FTIndustries/FTUno/ftuno.kicad_pcb

## KiCad design ftuno.kicad_pcb (2024-12-11)

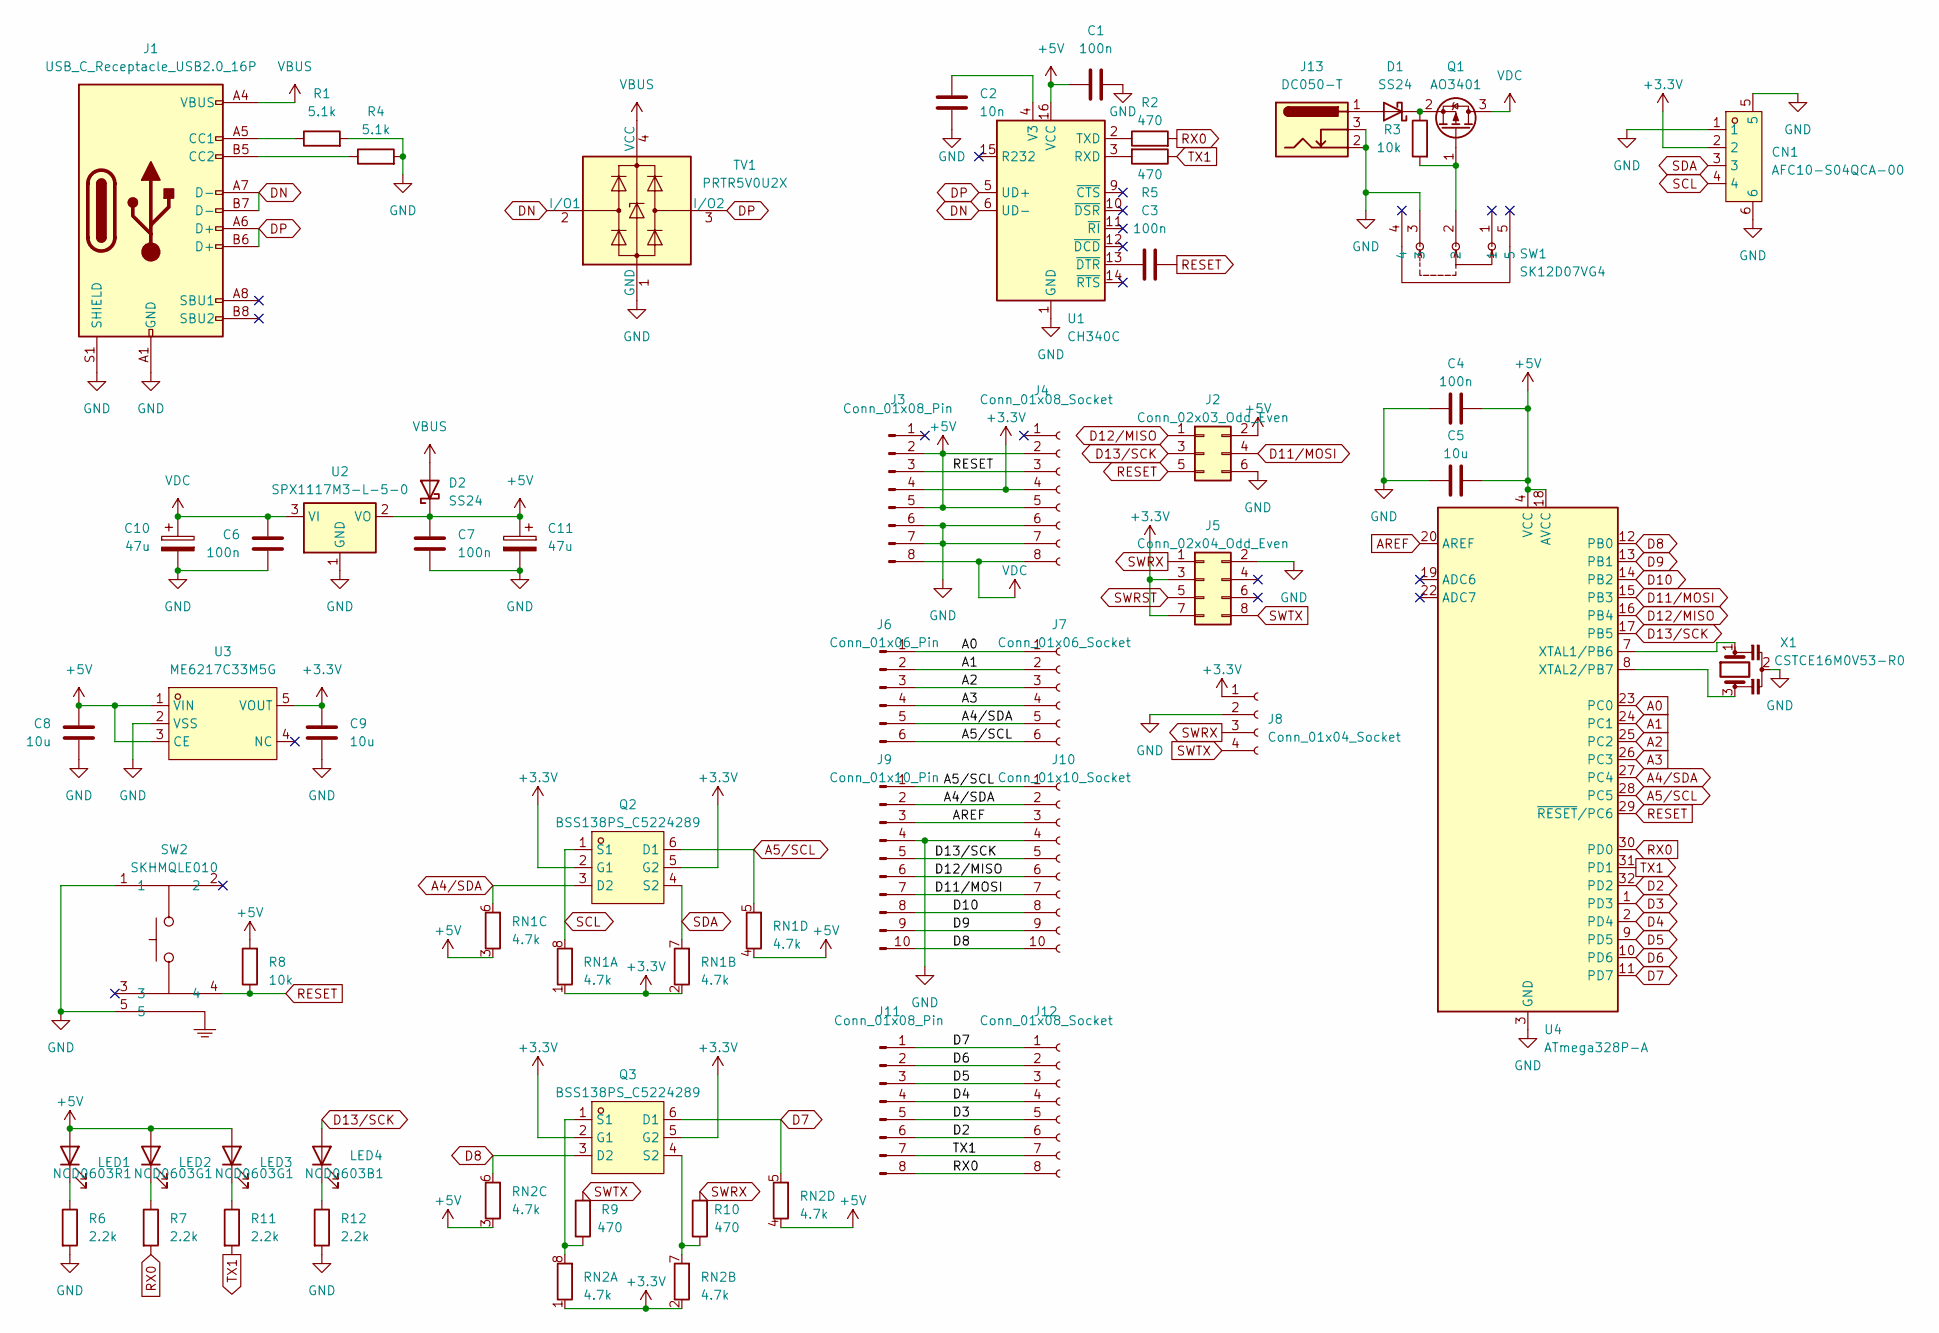
[picture p1: schematic ftuno.kicad_sch]

Parts:
C1, C3, C6, C7: 100n; C_0603_1608Metric
C2: 10n; C_0402_1005Metric
C4: 100n; C_0402_1005Metric
C5, C8, C9: 10u; C_0603_1608Metric
C10, C11: 47u; CP_Elec_6.3x5.4; LCSC Part C2836440
CN1: AFC10-S04QCA-00; CONN-SMD_AFC10-S04QCA-00; LCSC Part C2764183
D1, D2: SS24; D_SMA
J1: USB_C_Receptacle_USB2.0_16P; USB_C_Receptacle_G-Switch_GT-USB-7010ASV
J2: Conn_02x03_Odd_Even; PinHeader_2x03_P2.54mm_Vertical
J3, J11: Conn_01x08_Pin; PinHeader_1x08_P2.54mm_Vertical
J4, J12: Conn_01x08_Socket; PinSocket_1x08_P2.54mm_Vertical
J5: Conn_02x04_Odd_Even; PinSocket_2x04_P2.54mm_Vertical
J6: Conn_01x06_Pin; PinHeader_1x06_P2.54mm_Vertical
J7: Conn_01x06_Socket; PinSocket_1x06_P2.54mm_Vertical
J8: Conn_01x04_Socket; PinSocket_1x04_P2.54mm_Vertical
J9: Conn_01x10_Pin; PinHeader_1x10_P2.54mm_Vertical
J10: Conn_01x10_Socket; PinSocket_1x10_P2.54mm_Vertical
J13: DC050-T; DC-IN_DC050-T; LCSC Part C431534
LED1: NCD0603R1; LED_0603_1608Metric
LED2, LED3: NCD0603G1; LED_0603_1608Metric
LED4: NCD0603B1; LED_0603_1608Metric
Q1: AO3401; SOT-23
Q2, Q3: BSS138PS_C5224289; SOT-363_L2.1-W1.3-P0.65-LS2.3-BL; LCSC Part C5224289
R1, R4: 5.1k; R_0402_1005Metric
R2, R5, R9, R10: 470; R_0402_1005Metric
R3: 10k; R_0603_1608Metric
R6, R7, R11, R12: 2.2k; R_0402_1005Metric
R8: 10k; R_0402_1005Metric
RN1, RN2: 4.7k; R_Array_Convex_4x0603
SW1: SK12D07VG4; SW-TH_SK12D07VG4; LCSC Part C393937
SW2: SKHMQLE010; KEY-SMD_4P-L6.2-W6.5-P4.50-LS8.0_SKHMXX; LCSC Part C139767
TV1: PRTR5V0U2X; SOT-143
U1: CH340C; SOIC-16_3.9x9.9mm_P1.27mm
U2: SPX1117M3-L-5-0; SOT-223-3_TabPin2
U3: ME6217C33M5G; SOT-23-5_L3.0-W1.7-P0.95-LS2.8-BR; LCSC Part C427602
U4: ATmega328P-A; TQFP-32_7x7mm_P0.8mm
X1: CSTCE16M0V53-R0; OSC-SMD_3P-L3.2-W1.3-P0.95-L; LCSC Part C32180

Connections:
+3.3V: C9.1, CN1.2, J3.4, J4.4, J5.3, J5.7, J8.1, Q2.2 (G1), Q2.5 (G2), Q3.2 (G1), Q3.5 (G2), RN1.1 (R1.1), RN1.2 (R2.1), RN2.1 (R1.1), RN2.2 (R2.1), U3.5 (VOUT)
+5V: C1.1, C4.2, C5.2, C7.1, C8.1, C11.1, D2.1 (K), J2.2, J3.2, J3.5, J4.2, J4.5, LED1.2 (A), LED2.2 (A), LED3.2 (A), R8.2, RN1.3 (R3.1), RN1.4 (R4.1), RN2.3 (R3.1), RN2.4 (R4.1), U1.16 (VCC), U2.2 (VO), U3.1 (VIN), U3.3 (CE), U4.4 (VCC), U4.6 (VCC), U4.18 (AVCC)
A0: J6.1, J7.1, U4.23 (PC0)
A1: J6.2, J7.2, U4.24 (PC1)
A2: J6.3, J7.3, U4.25 (PC2)
A3: J6.4, J7.4, U4.26 (PC3)
A4/SDA: J6.5, J7.5, J9.2, J10.2, Q2.3 (D2), RN1.6 (R3.2), U4.27 (PC4)
A5/SCL: J6.6, J7.6, J9.1, J10.1, Q2.6 (D1), RN1.5 (R4.2), U4.28 (PC5)
AREF: J9.3, J10.3, U4.20 (AREF)
D2: J11.6, J12.6, U4.32 (PD2)
D3: J11.5, J12.5, U4.1 (PD3)
D4: J11.4, J12.4, U4.2 (PD4)
D5: J11.3, J12.3, U4.9 (PD5)
D6: J11.2, J12.2, U4.10 (PD6)
D7: J11.1, J12.1, Q3.6 (D1), RN2.5 (R4.2), U4.11 (PD7)
D8: J9.10, J10.10, Q3.3 (D2), RN2.6 (R3.2), U4.12 (PB0)
D9: J9.9, J10.9, U4.13 (PB1)
D10: J9.8, J10.8, U4.14 (PB2)
D11/MOSI: J2.4, J9.7, J10.7, U4.15 (PB3)
D12/MISO: J2.1, J9.6, J10.6, U4.16 (PB4)
D13/SCK: J2.3, J9.5, J10.5, LED4.2 (A), U4.17 (PB5)
DN: J1.A7 (D-), J1.B7 (D-), TV1.2 (I/O1), U1.6 (UD-)
DP: J1.A6 (D+), J1.B6 (D+), TV1.3 (I/O2), U1.5 (UD+)
GND: C1.2, C2.2, C4.1, C5.1, C6.2, C7.2, C8.2, C9.2, C10.2, C11.2, CN1.1, CN1.5, CN1.6, J1.A1 (GND), J1.A12 (GND), J1.B1 (GND), J1.B12 (GND), J1.S1 (SHIELD), J2.6, J3.6, J3.7, J4.6, J4.7, J5.2, J8.2, J9.4, J10.4, J13.2, J13.3, R1.2, R4.2, R6.2, R12.2, SW1.3, SW2.1, SW2.5, TV1.1 (GND), U1.1 (GND), U2.1 (GND), U3.2 (VSS), U4.3 (GND), U4.5 (GND), U4.21 (GND), X1.2
unnamed: D1.2 (A), J13.1
unnamed: D1.1 (K), Q1.2 (S), R3.1
unnamed: J1.A5 (CC1), R1.1
unnamed: J1.B5 (CC2), R4.1
unnamed: LED1.1 (K), R6.1
unnamed: LED2.1 (K), R7.1
unnamed: LED3.1 (K), R11.1
unnamed: LED4.1 (K), R12.1
unnamed: Q1.1 (G), R3.2, SW1.2
unnamed: Q3.1 (S1), R9.1, RN2.8 (R1.2)
unnamed: Q3.4 (S2), R10.1, RN2.7 (R2.2)
unnamed: R5.2, U1.3 (RXD)
unnamed: R2.1, U1.2 (TXD)
unnamed: C2.1, U1.4 (V3)
unnamed: C3.1, U1.13 (~DTR)
unnamed: U4.7 (XTAL1/PB6), X1.1
unnamed: U4.8 (XTAL2/PB7), X1.3
RESET: C3.2, J2.5, J3.3, J4.3, R8.1, SW2.4, U4.29 (~RESET/PC6)
RX0: J11.8, J12.8, R2.2, R7.2, U4.30 (PD0)
SCL: CN1.4, Q2.1 (S1), RN1.8 (R1.2)
SDA: CN1.3, Q2.4 (S2), RN1.7 (R2.2)
SWRST: J5.5
SWRX: J5.1, J8.3, R10.2
SWTX: J5.8, J8.4, R9.2
TX1: J11.7, J12.7, R5.1, R11.2, U4.31 (PD1)
VBUS: D2.2 (A), J1.A4 (VBUS), J1.A9 (VBUS), J1.B4 (VBUS), J1.B9 (VBUS), TV1.4 (VCC)
VDC: C6.1, C10.1, J3.8, J4.8, Q1.3 (D), U2.3 (VI)

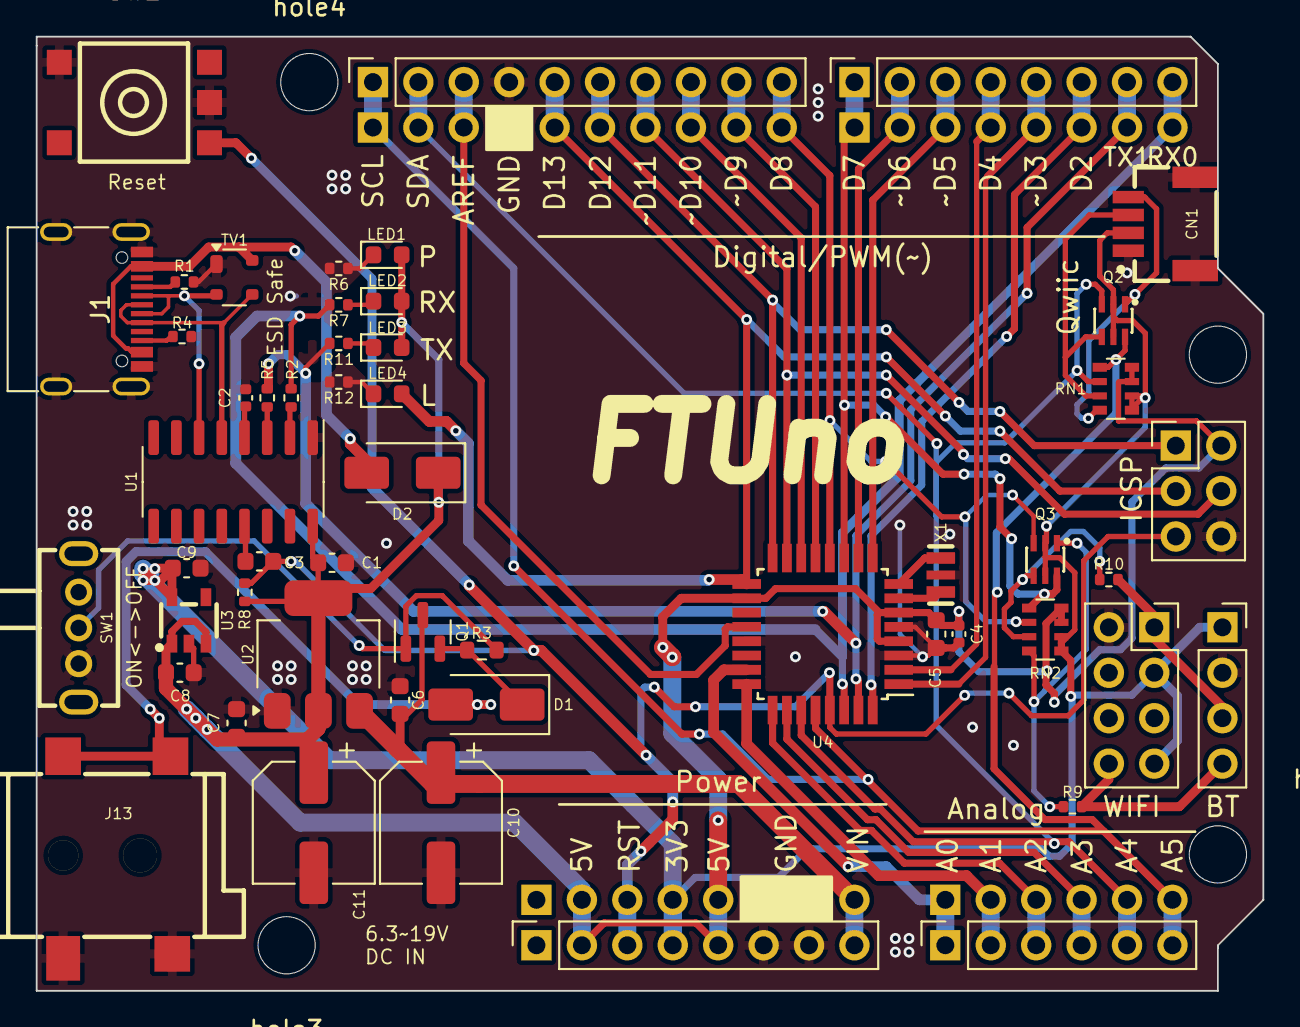
[picture p2: board ftuno.kicad_pcb from above]

Board: 2 copper layers, 68.6 x 53.3 mm, 60 parts (0 on the bottom side), 50 nets.

Other parts of the board:
hole1, hole2, hole3, hole4: MountingHole_3.2mm_M3
