FTIndustries/FTUno/(commit log)

2024-01-03 added UART level convertor, moved components, solved UART LED issue
    [ftuno.kicad_pcb, ftuno.kicad_sch]
2024-01-06 change softwareserial pin to D7, D8
    [ftuno.kicad_pcb, ftuno.kicad_sch]
2024-01-10 smaller reference text
    [ftuno.kicad_pcb]
2024-01-29 use more common DC conn
    [ftuno.kicad_pcb, ftuno.kicad_sch]
2024-04-21 fix qwiic
    [ftuno.kicad_sch]
2024-04-23 PCB update, replace USB conn, replace TVS, cleanup
    [ftuno.kicad_pcb, ftuno.kicad_sch]
2024-05-19 get rid of buck convertor and use LDO instead
    [ftuno.kicad_pcb, ftuno.kicad_sch]
2024-05-29 fix qwiic pin arrangement, move usb conn
    [ftuno.kicad_pcb, ftuno.kicad_sch]
2024-09-02 refine 1117 in and out
    [ftuno.kicad_pcb, ftuno.kicad_sch]
2024-11-29 silkscreen rework
    [ftuno.kicad_pcb]
2024-12-11 use seperate resistors for led, use higher rns for level shifters
    [ftuno.kicad_pcb, ftuno.kicad_sch]
